Pranet-Godavarty/Marqee-upgrade/(list of files, drawings)

Other design files:
pcb/PCB1.pcbdoc
pcb/Schematic1P1.schdoc
