Pranet-Godavarty/Marqee-upgrade/(commit log)

2026-10-08 Revise README with updated specifications and instructions
    Updated power supply specifications and PCB assembly instructions. Added firmware details and clarified bill of materials.
2026-10-08 Add root bom.csv, move firmware into firmware/, remove BOM.xlsx
    [BOM.xlsx, bom.csv]
2026-10-08 Remove Altium .pcbdoc/.schdoc exports
    [PCB1.pcbdoc, Schematic1P1.schdoc]
2026-10-08 README: list PCB.epro2
